frawgmanman/COSMOS23-C7-H4O/archive/2022-c7/presentations/COSMOS22-C13-1-boat.pdf

# Boat Team

Ty, Josh, Deon, Justin, Saarth, and Daisy

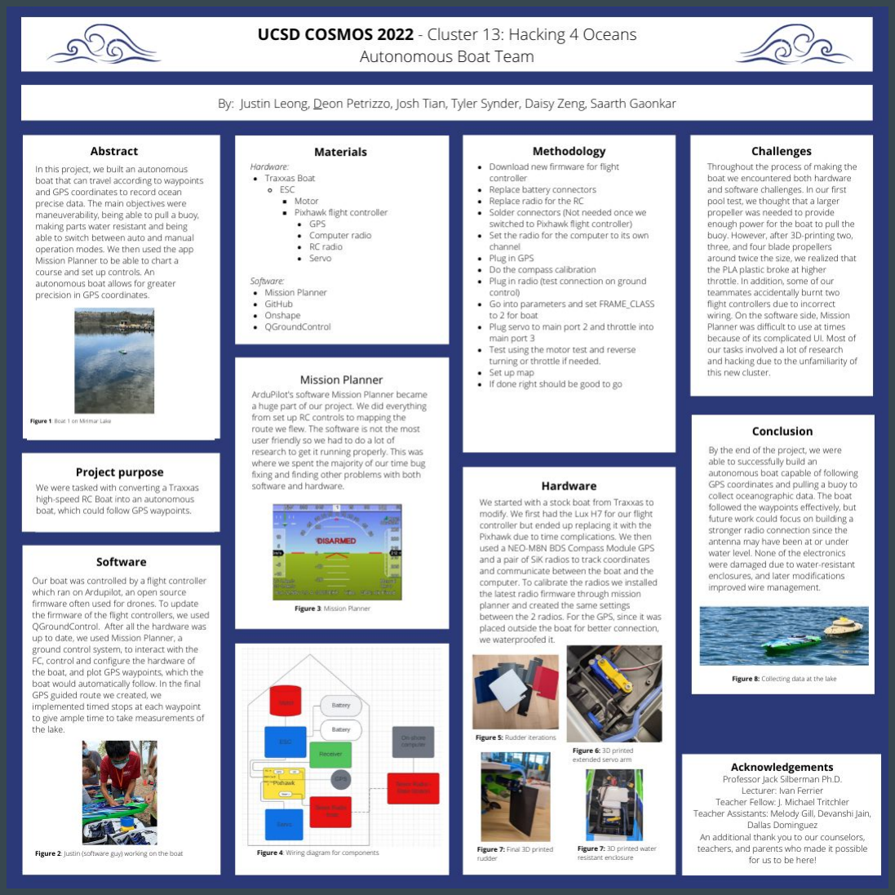
[picture p5: figure]

## Goals

- RC Boat => Autonomous Boat
- Maneuverability
- Pulling a load
- Water resistance
- Fail safe mechanism

## Software

- Ardupilot (firmware on flight controller)
- Mission Planner (ground control software)
- Configure hardware
- Plot and run GPS routes
- Add specific waypoint events

## Hardware: Electronics

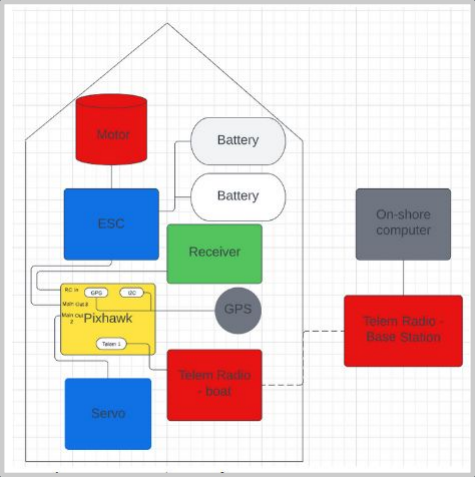
[picture p6: figure]

## Hardware: Custom 3D printed parts

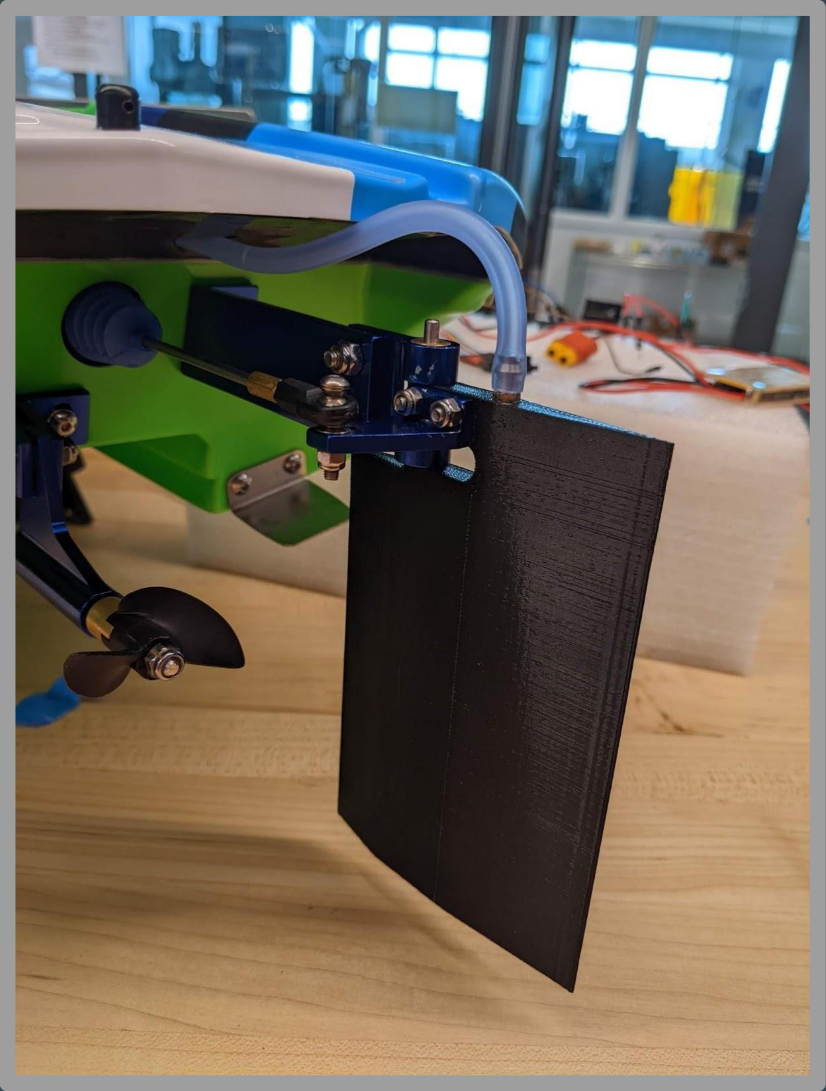
[picture p7: figure]
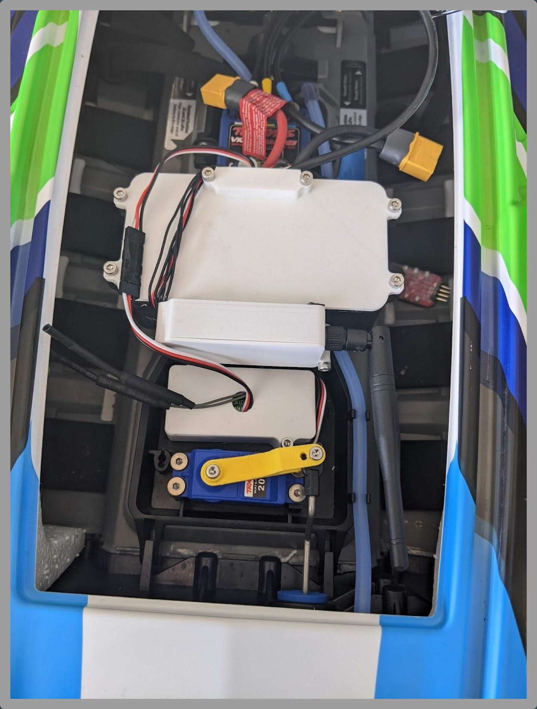
[picture p8: figure]
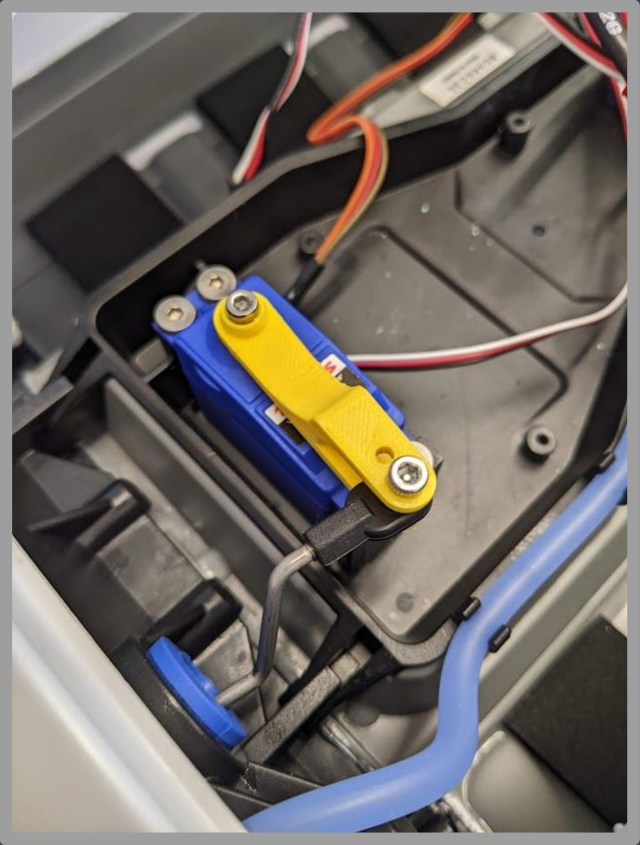
[picture p9: figure]

Improved steering system | Water resistant enclosures for the electronics

## Hardware: Iterations

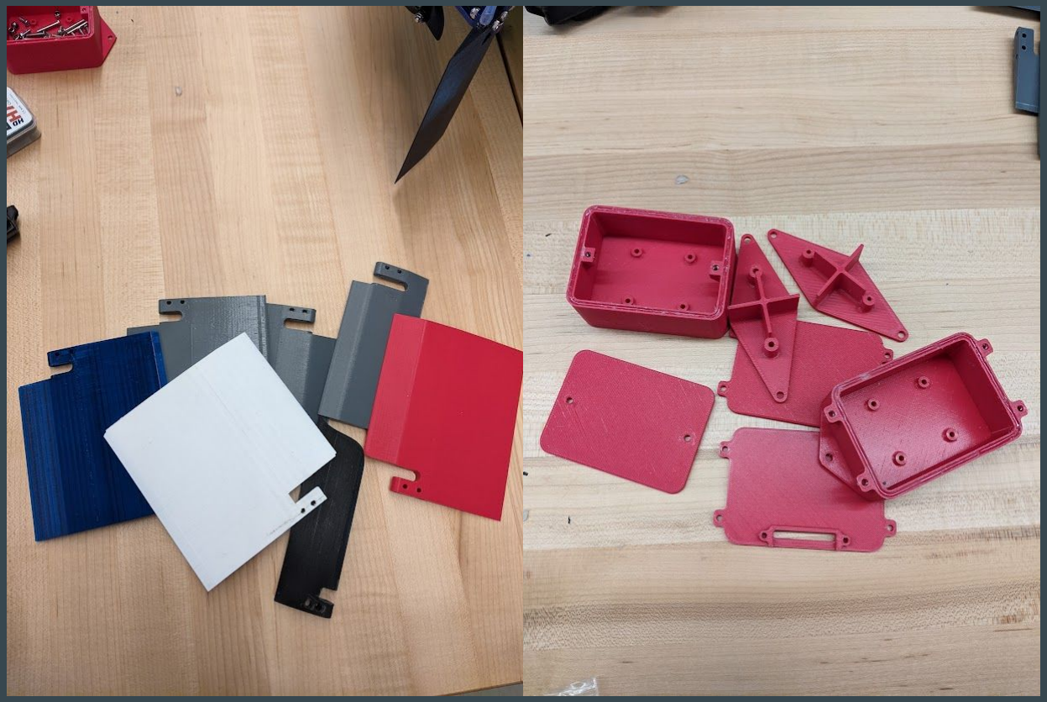
[picture p10: figure]

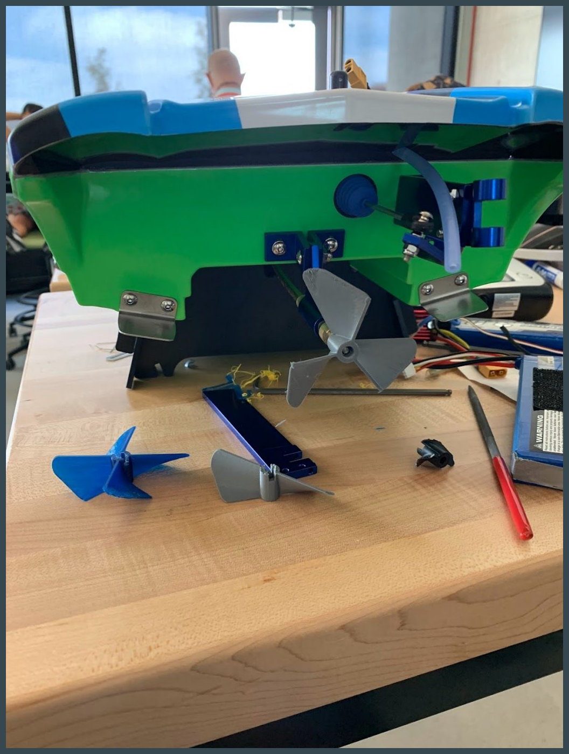
[picture p11: figure]

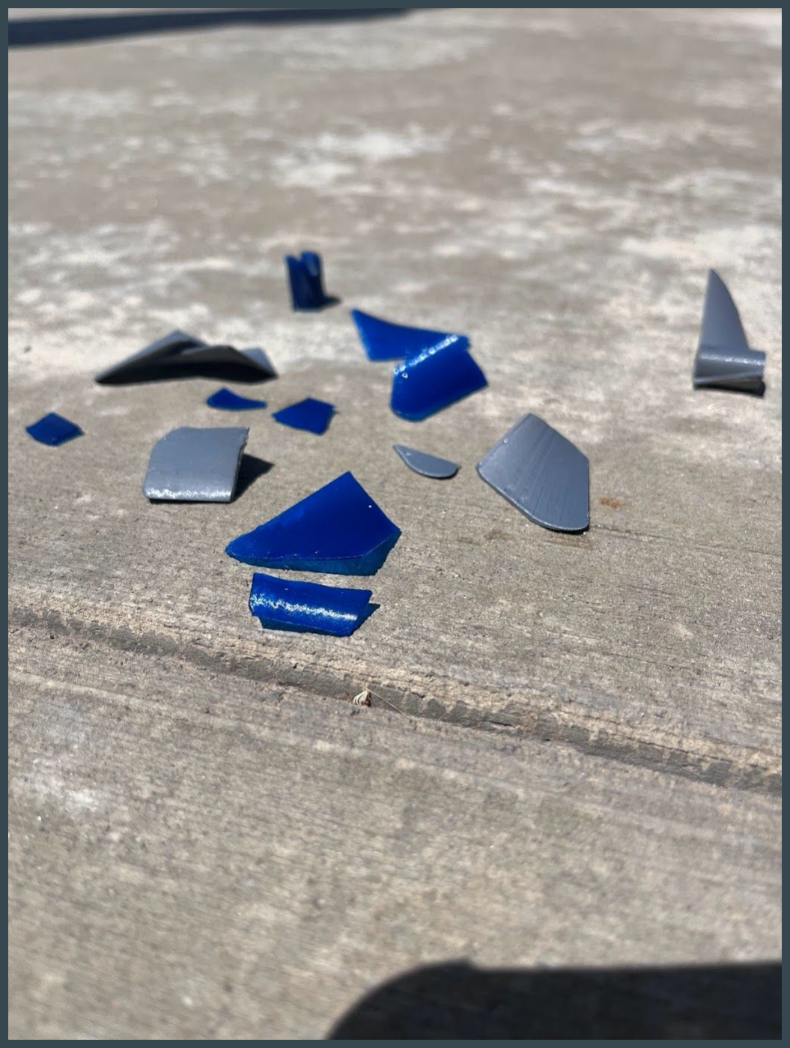
[picture p12: figure]

## Challenges

Hardware:
- Wiring GPS
- Frying boards
Software:
- Mission Planner => complicated UI
- Pairing Sik radios

## Conclusion

Success:
- Boat followed GPS waypoints
- No water damage
- Agile steering
Future Improvements:
- Stronger radio connection

## Acknowledgements

Professor: Jack Silberman Ph.D.
Lecturer: Ivan Ferrier
Teacher Fellow: J. Michael Tritchler
Teacher Assistants: Melody Gill, Devanshi Jain, Dallas Dominguez
An additional thank you to our counselors, teachers, and parents who made it possible for us to be here!
