frawgmanman/COSMOS23-C7-H4O/archive/2022-c7/presentations/COSMOS22-C13-3-data_acquisition.pdf

# UCSD COSMOS 2022

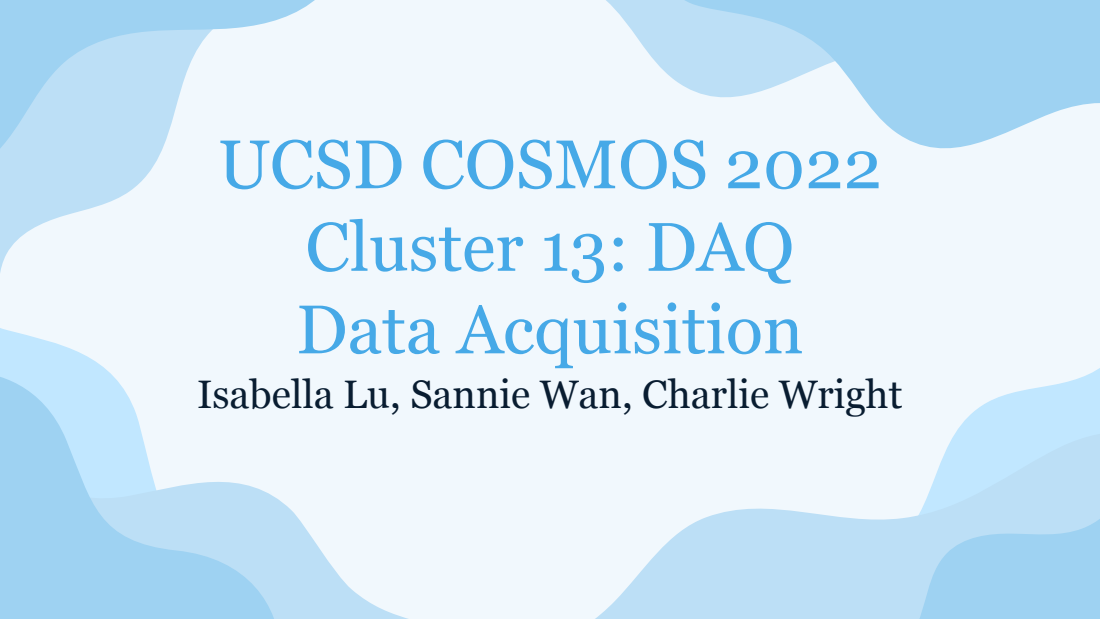
[picture p13: page 1]
Cluster 13: DAQ Data Acquisition

Isabella Lu, Sannie Wan, Charlie Wright

# Meet the Team

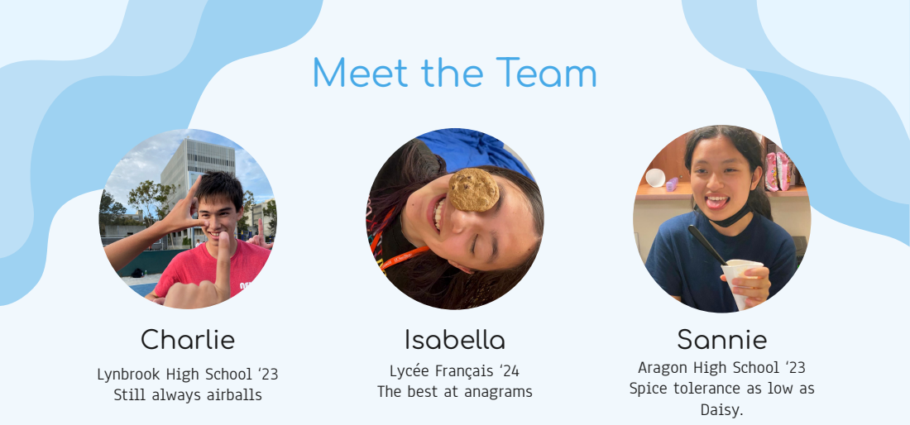
[picture p14: page 2]
Daisy.

Charlie
Lynbrook High School ‘23
Still always airballs

Isabella
Lycée Français ‘24
The best at anagrams

Sannie
Aragon High School ‘23
Spice tolerance as low as

# Background

There has recently been many contributions to big ocean data. In order to understand the environment around us through robotics, sensors were placed on a buoy, which was towed by a boat. This was driven around Miramar Reservoir.

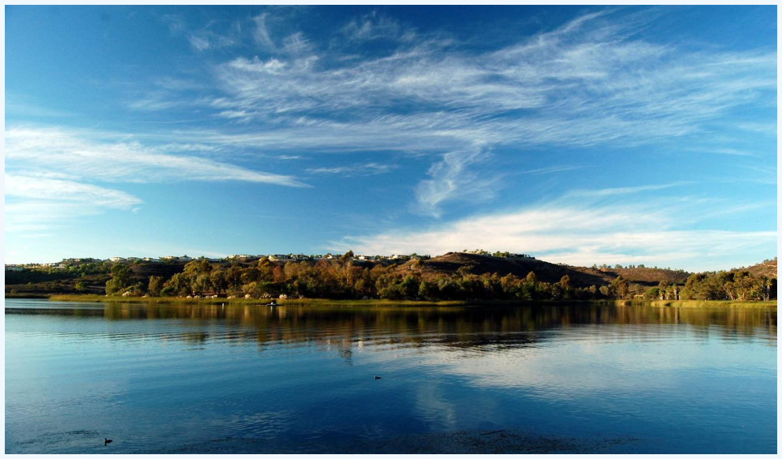
[picture p15: figure]
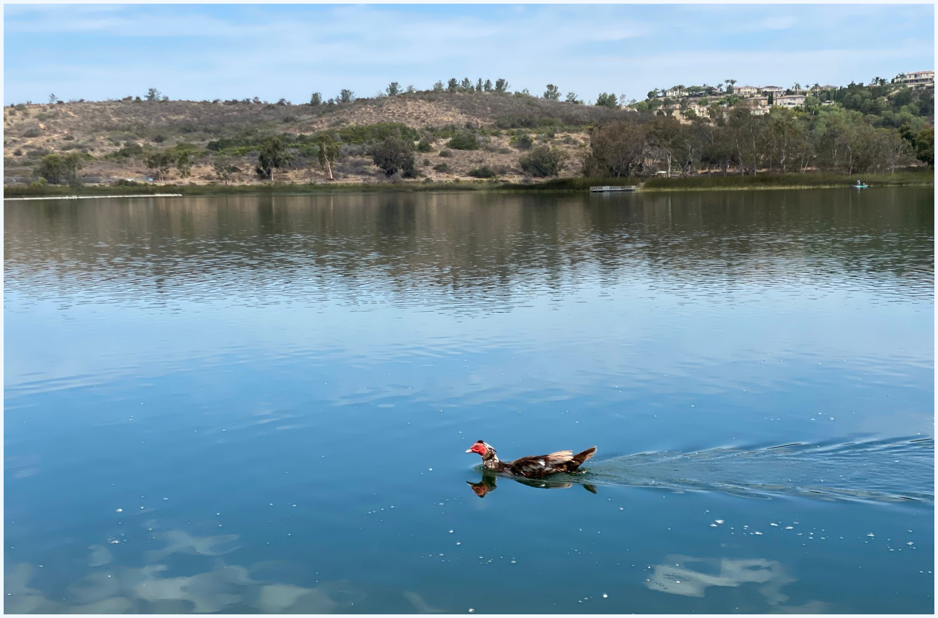
[picture p16: figure]

# Project Scope

Tasks:
- Use pH, TDS, and temperature sensors
- Collect and transmit frequent and reliable data.
- Wire up the sensors in the buoy

We communicated our data through serial communication from an arduino to ESP32.

Goal: collect pH, total dissolved solids (TDS), and temperature data from Miramar Lake, and send it back to an onshore server for further analysis.

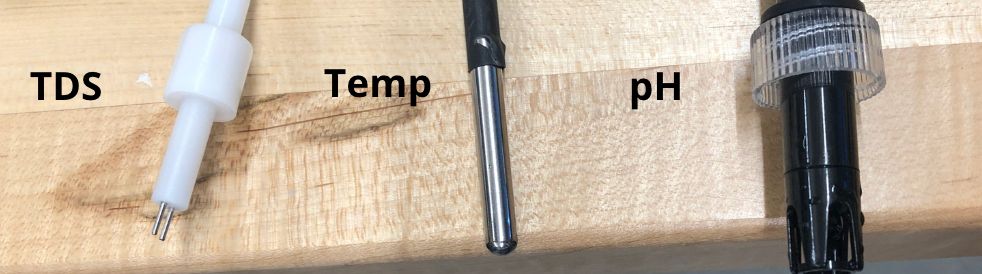
[picture p17: figure]

# Wiring diagram

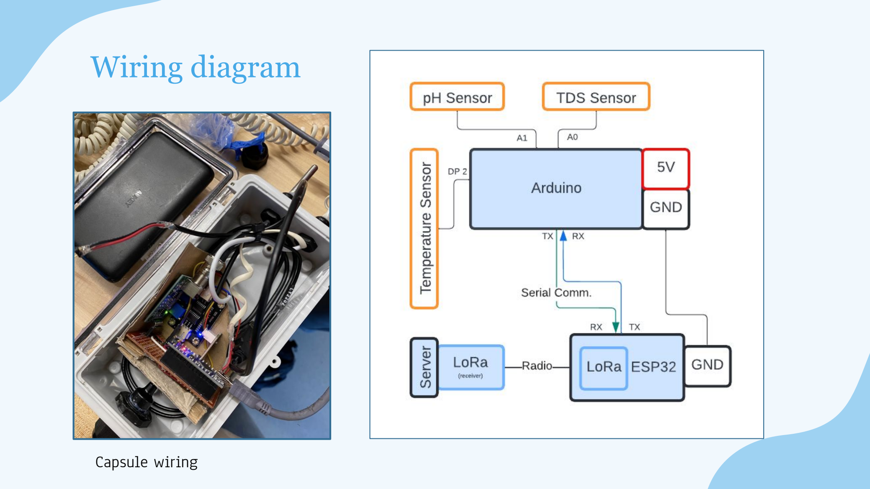
[picture p18: page 5]

## Capsule wiring

# Materials

Hardware:
- Arduino Uno and Nano
- ESP32 with LoRa
- Protoboard, breadboard
- Sensors: pH, Total
Dissolved Solids), and
temperature
- 1000 ppm TDS
calibration solution
- 4, 7, and 10 pH
calibration solution
- Thermometer
- Capsule
Hardware
- Motor
- Motor
controller

Software:
- Arduino IDE
- Github
- Onshape

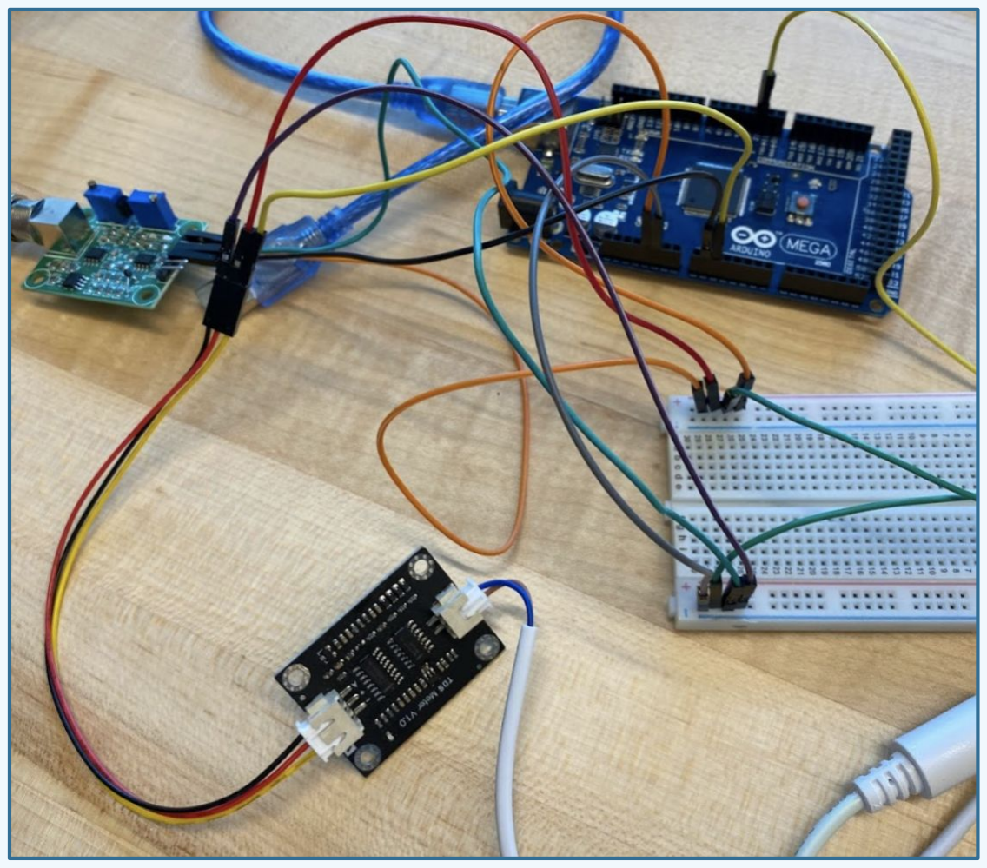
[picture p19: figure]

## Prototyping with breadboard and sensors

# Reliable Data Method

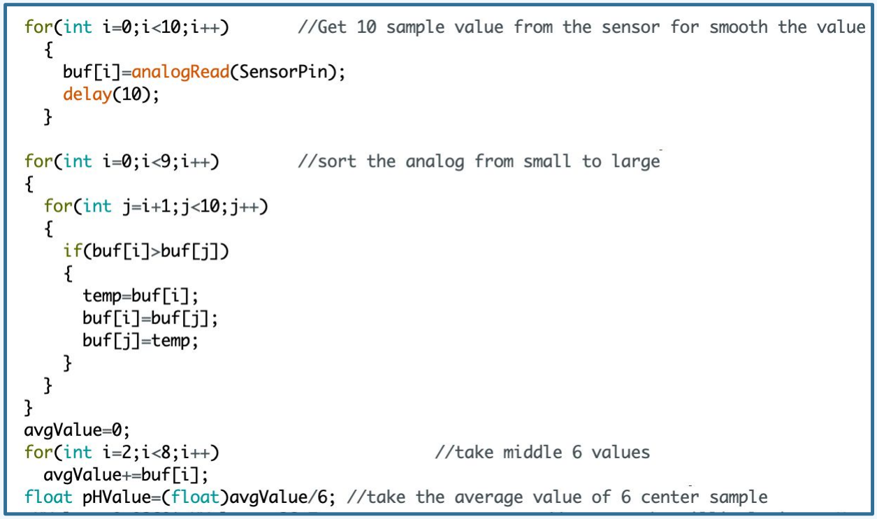
[picture p20: figure]

When taking the measurement of pH, we used:
- Oversampling (takes 10 values per function call)
- Averaging the six median values

pH oversampling →

# Sensors Calibration

We took three known data points for pH, plotted

them in a scatter chart in Google Sheets and used

the trendline tool to find the equation relating the

analog value to the actual pH value.

Then, we plugged in that equation into our

Arduino code.

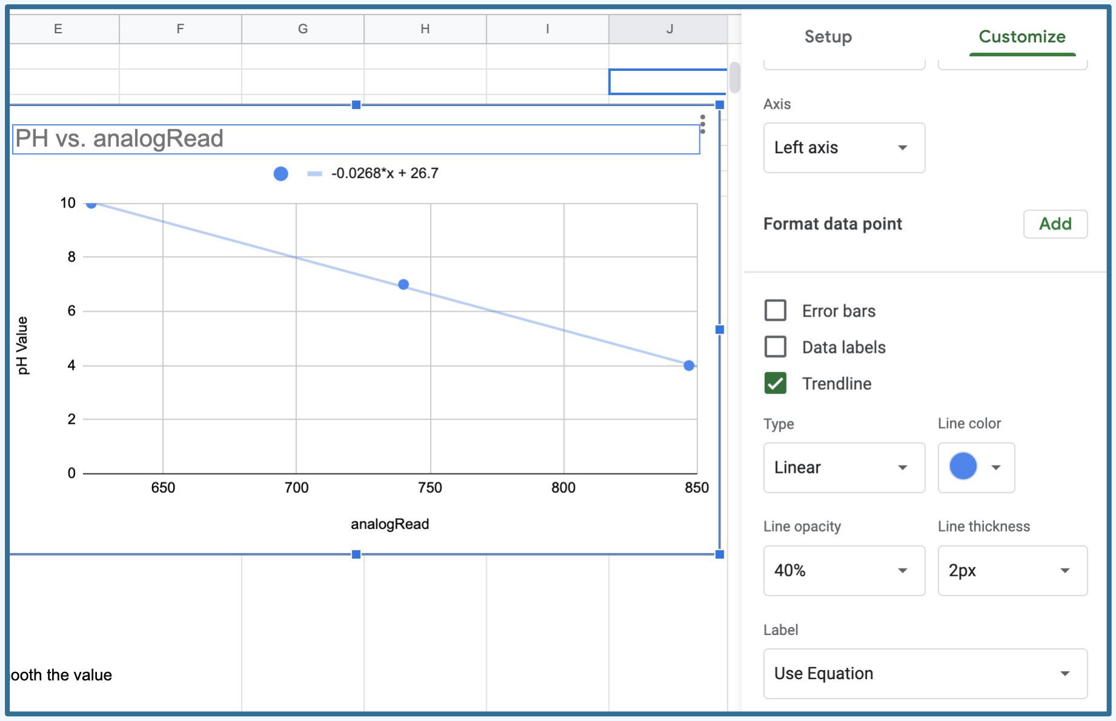
[picture p21: figure]

## Line of best fit on Google Sheets

# Challenges

- Synchronization of different electrical

components–communication with other teams to

coordinate "who sends what and when"

- Uploading code to the ESP32
- Flooding in the buoy
- Had to re-calibrate and test all sensors as

well as replace some

- Sensor inconsistency, especially with the pH and

TDS sensor

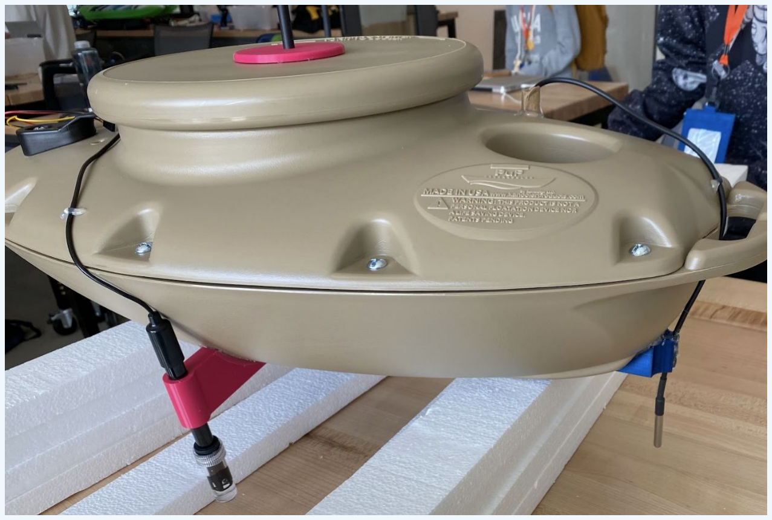
[picture p22: figure]

Buoy 1 with pH sensor (left) and temperature sensor (right). TDS sensor not shown.

# Field testing Results

- In a controlled environment, the sensor readings had very high accuracy
- Immediately after dropping in the lake, pH was inaccurate: 15-18
- Realistic pH: 7-8
- TDS might be too high: ~1000 ppm
- Realistic TDS: 50-300
- 2136 data points around the lake were collected
- Data was gibberish initially during testing due to a wiring malfunction, troubleshooted at the lake

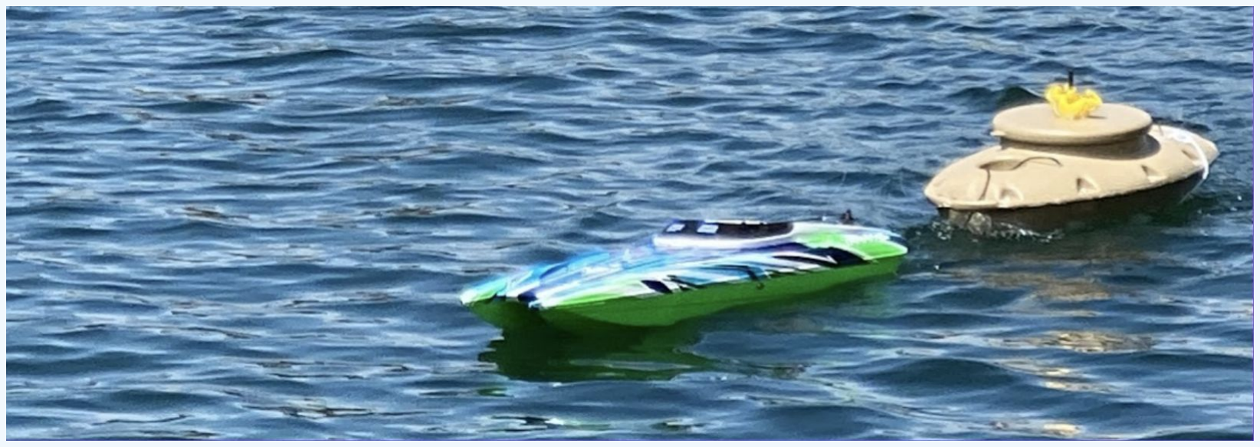
[picture p23: figure]

# Opportunities for further research

- Understand the root causes of wrong data values
- Possible reasons: wind, not fully submerged, current, temperature
- We tested fast-flowing sample lake water with pH sensor. The pH didn’t change significantly. According to our observations, current did not affect pH.
- Temperature of the lake was not in the extremes
- More verification such as pH test strips
- More time for field testing
- Testing sensors deeper in the lake

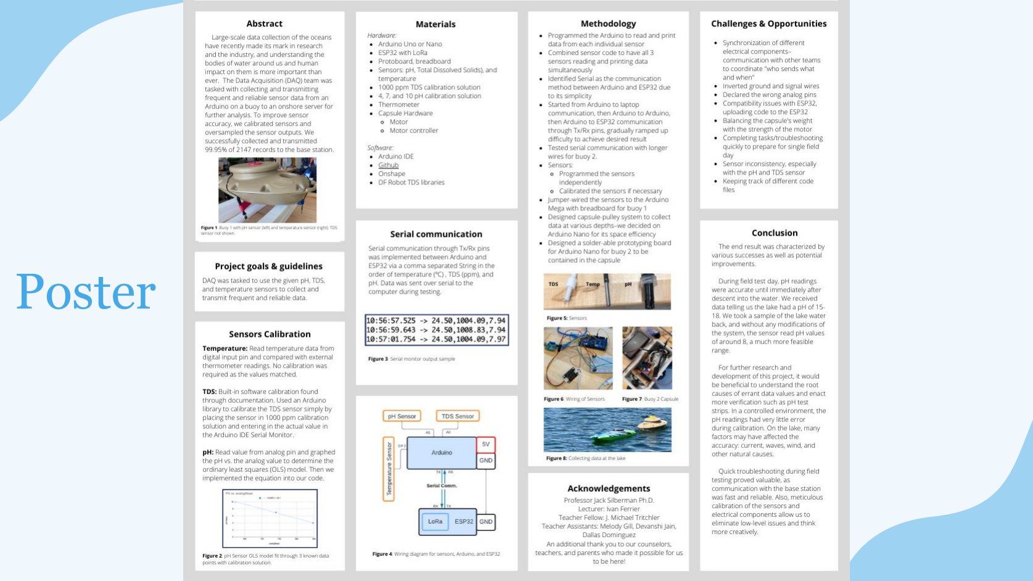
[picture p24: page 12]

# Poster

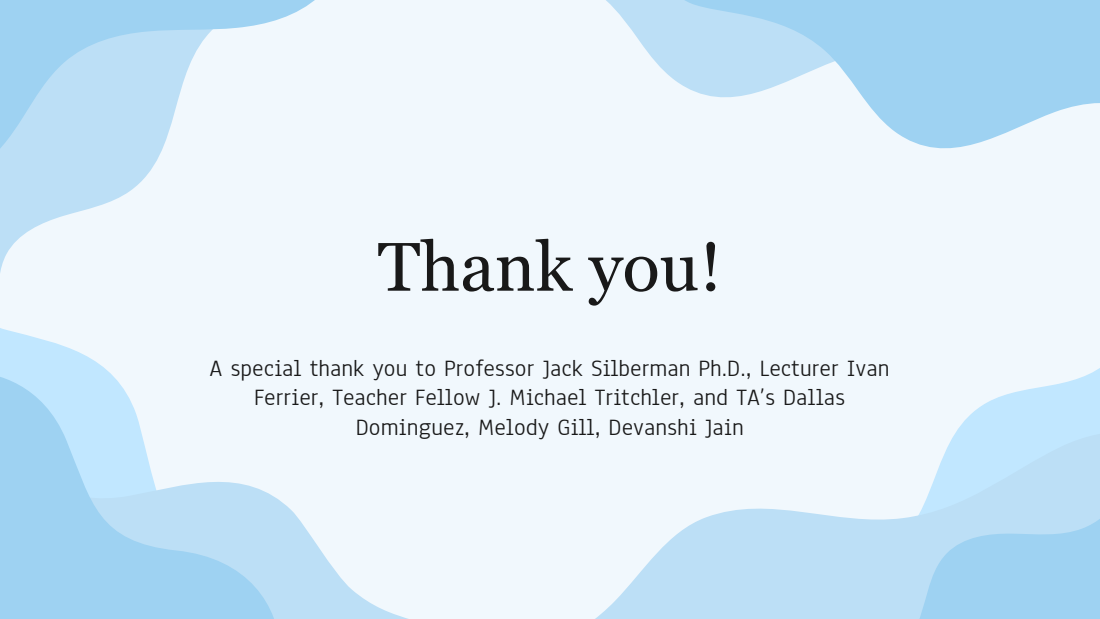
[picture p25: page 13]
Thank you!

A special thank you to Professor Jack Silberman Ph.D., Lecturer Ivan
Ferrier, Teacher Fellow J. Michael Tritchler, and TA’s Dallas

Dominguez, Melody Gill, Devanshi Jain
