frawgmanman/COSMOS23-C7-H4O/archive/2022-c7/2-buoy/Buoy2/PostTestDay/General_Assembly.step

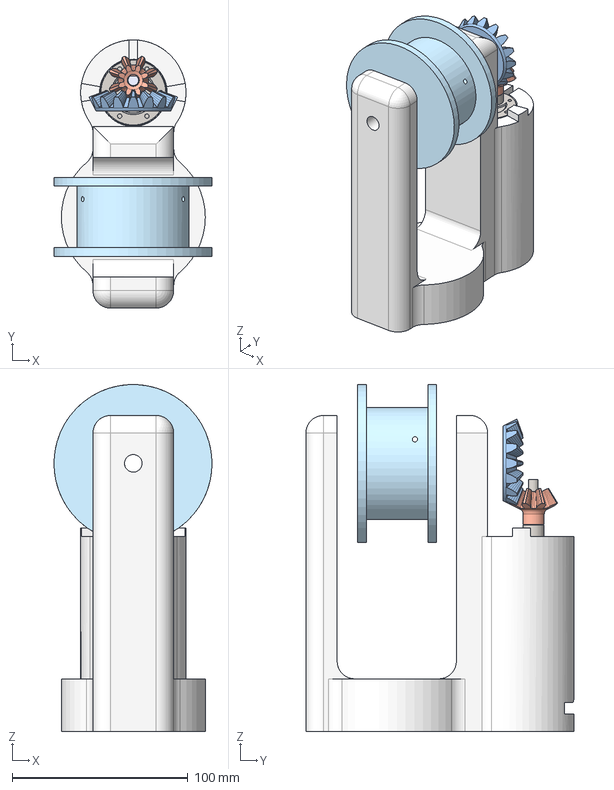
[picture p26: CAD file, 2023-07-07, an earlier design]
archive/2022-c7/2-buoy/Buoy2/PostTestDay/General_Assembly.step
90.0 x 152.7 x 197.6 mm
Gear 1
Gear 2
am-2964a Neverest Classic 40
