frawgmanman/COSMOS23-C7-H4O/archive/2022-c7/2-buoy/Buoy2/(Final) Cup Holder Piece (2).stl

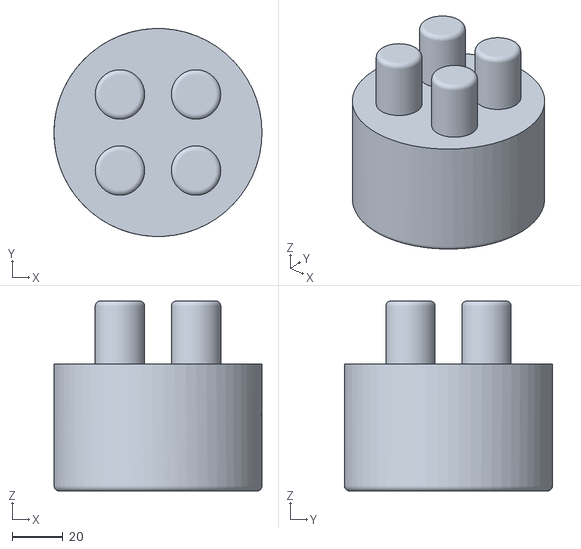
[picture p28: CAD file, 2023-07-07, an earlier design]
archive/2022-c7/2-buoy/Buoy2/(Final) Cup Holder Piece (2).stl
82.0 x 82.0 x 74.9
