frawgmanman/COSMOS23-C7-H4O/archive/2022-c7/2-buoy/Capsule/Arduino Uno Case - Top.step

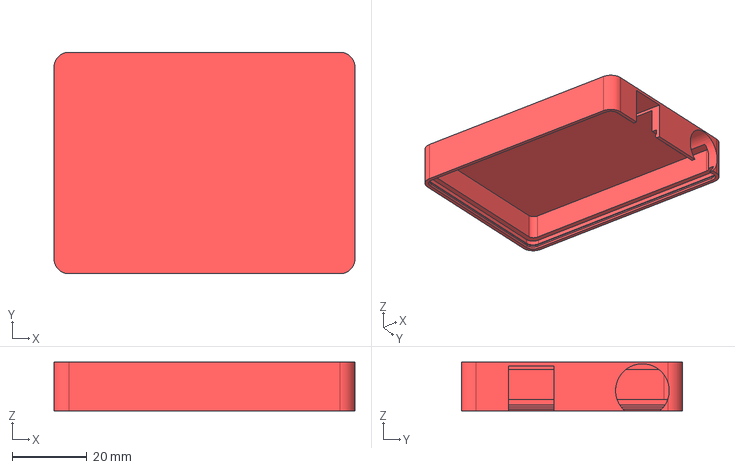
[picture p29: CAD file, 2023-07-07, an earlier design]
archive/2022-c7/2-buoy/Capsule/Arduino Uno Case - Top.step
80.6 x 59.3 x 13.0 mm
