frawgmanman/COSMOS23-C7-H4O/archive/2022-c7/2-buoy/Buoy1/Spool wheel first iteration.step

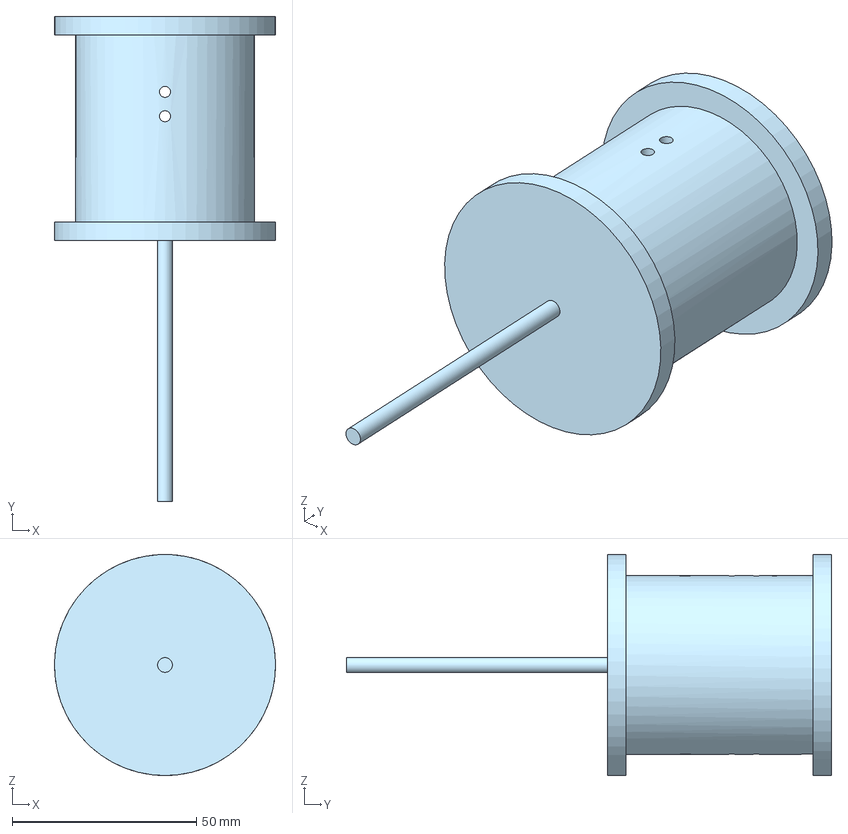
[picture p30: CAD file, 2023-07-07, an earlier design]
archive/2022-c7/2-buoy/Buoy1/Spool wheel first iteration.step
60.0 x 131.7 x 60.0 mm
