frawgmanman/COSMOS23-C7-H4O/archive/2022-c7/2-buoy/Buoy2/PostTestDay/Motor_Casing_Structure (1).step

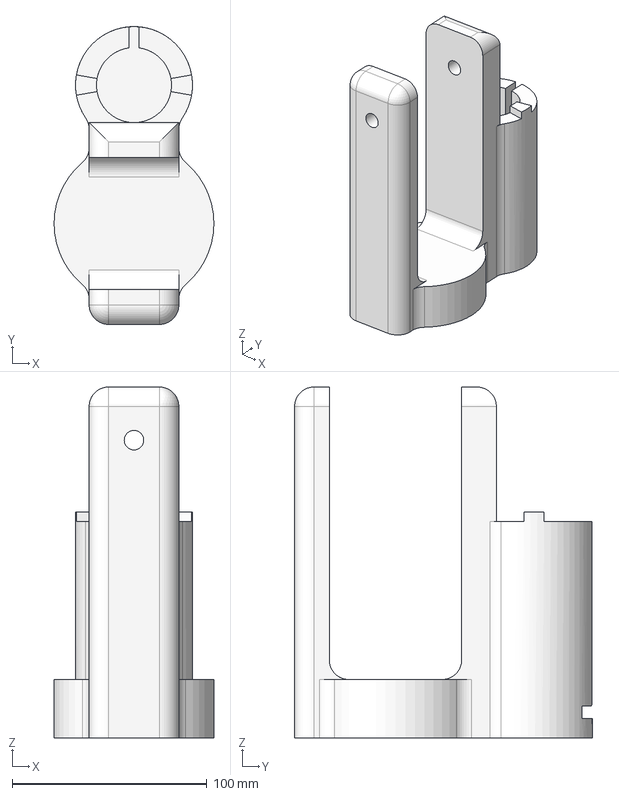
[picture p31: CAD file, 2023-07-07, an earlier design]
archive/2022-c7/2-buoy/Buoy2/PostTestDay/Motor_Casing_Structure (1).step
82.0 x 152.7 x 180.0 mm
