frawgmanman/COSMOS23-C7-H4O/archive/2022-c7/2-buoy/Capsule/Arduino Uno Case - Bottom.step

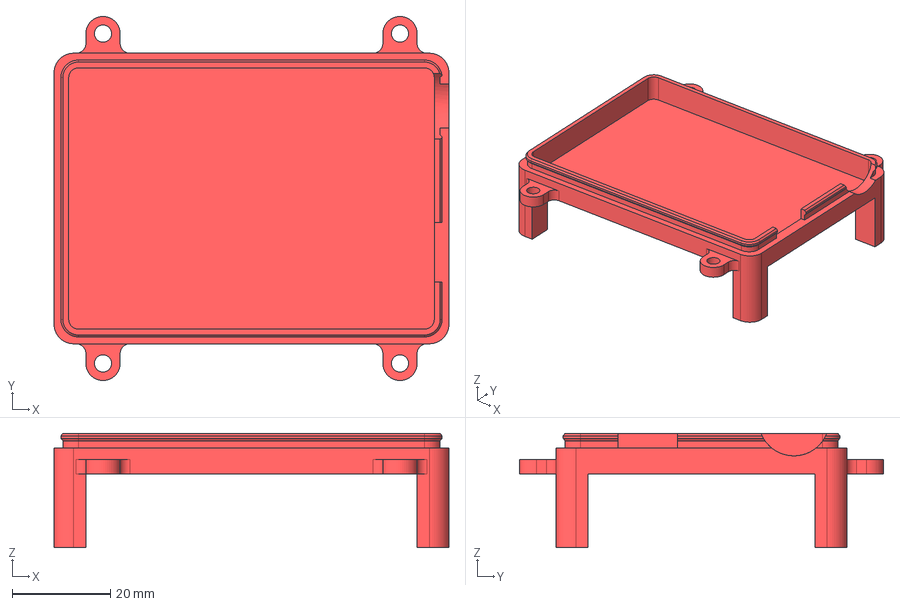
[picture p32: CAD file, 2023-07-07, an earlier design]
archive/2022-c7/2-buoy/Capsule/Arduino Uno Case - Bottom.step
80.6 x 74.3 x 23.3 mm
