frawgmanman/COSMOS23-C7-H4O/archive/2022-c7/2-buoy/Buoy1/Ph sensor.step

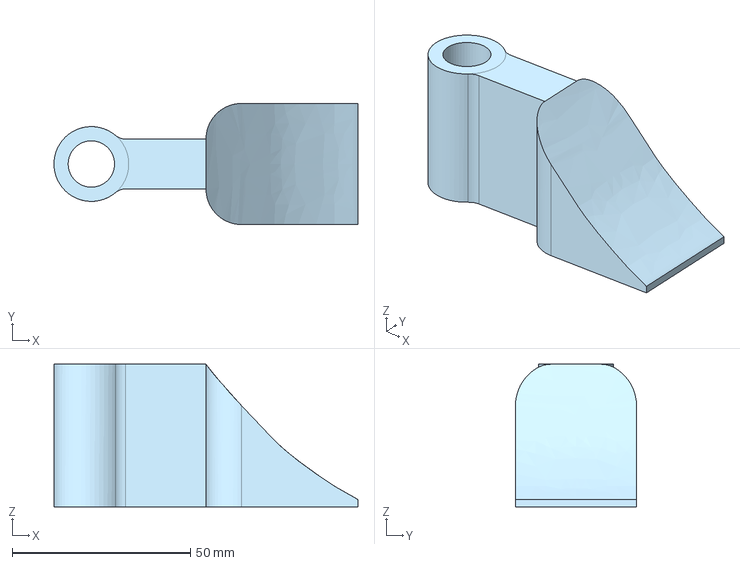
[picture p33: CAD file, 2023-07-07, an earlier design]
archive/2022-c7/2-buoy/Buoy1/Ph sensor.step
85.3 x 34.0 x 40.0 mm
