frawgmanman/COSMOS23-C7-H4O/archive/2022-c7/2-buoy/Buoy2/Final Spool Wheel (1).stl

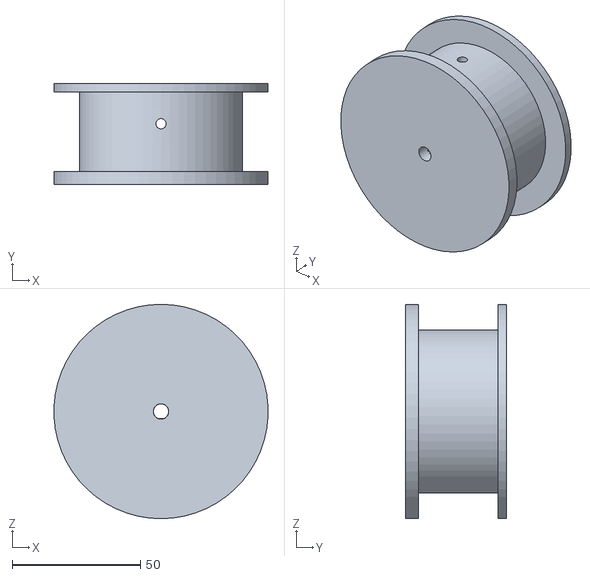
[picture p34: CAD file, 2023-07-07, an earlier design]
archive/2022-c7/2-buoy/Buoy2/Final Spool Wheel (1).stl
83.5 x 39.6 x 83.7
