frawgmanman/COSMOS23-C7-H4O/archive/2022-c7/2-buoy/Buoy2/PostTestDay/Gear_1_1.step

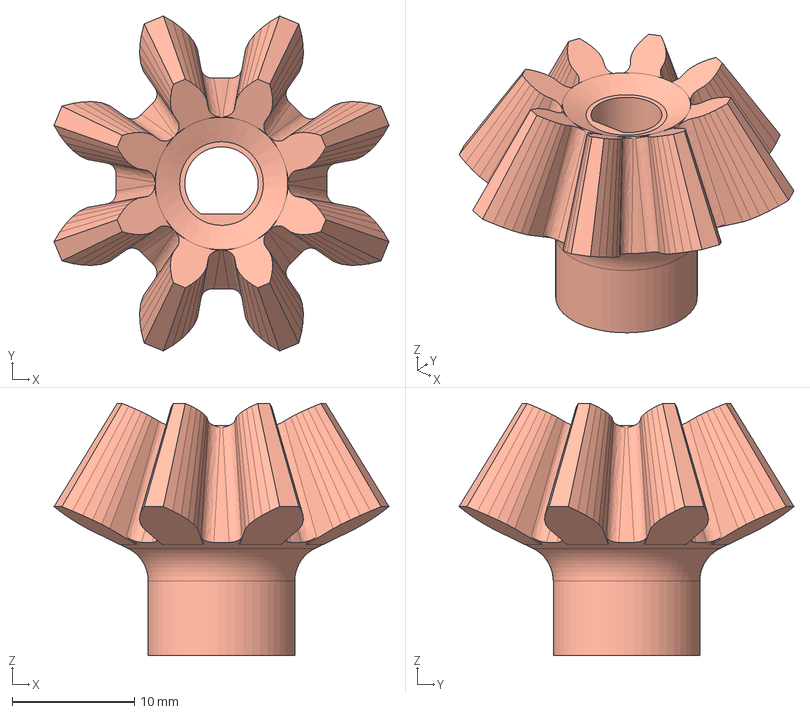
[picture p35: CAD file, 2023-07-07, an earlier design]
archive/2022-c7/2-buoy/Buoy2/PostTestDay/Gear_1_1.step
27.4 x 27.4 x 20.6 mm
