frawgmanman/COSMOS23-C7-H4O/archive/2022-c7/2-buoy/Buoy2/PostTestDay/Spool.step

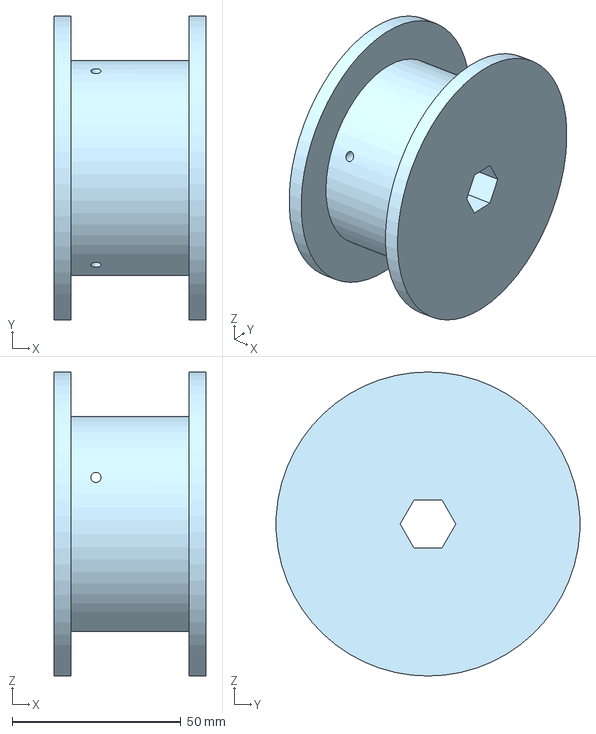
[picture p36: CAD file, 2023-07-07, an earlier design]
archive/2022-c7/2-buoy/Buoy2/PostTestDay/Spool.step
45.0 x 89.9 x 90.0 mm
