frawgmanman/COSMOS23-C7-H4O/archive/2022-c7/2-buoy/Buoy2/Spool Holder v1 (1).stl

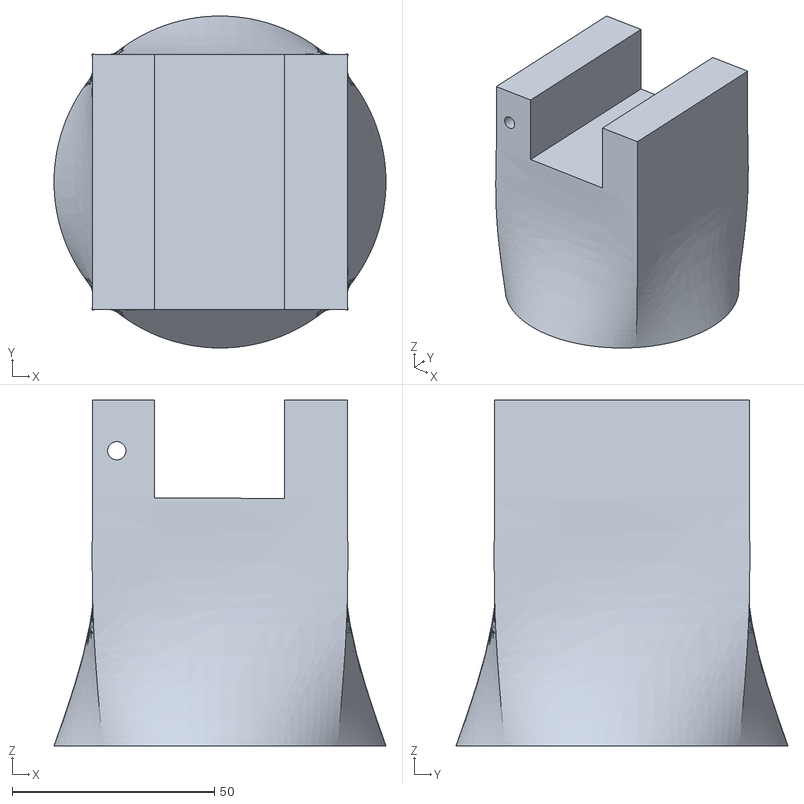
[picture p37: CAD file, 2023-07-07, an earlier design]
archive/2022-c7/2-buoy/Buoy2/Spool Holder v1 (1).stl
82.0 x 82.0 x 85.4
