frawgmanman/COSMOS23-C7-H4O/archive/2022-c7/2-buoy/Buoy1/TDS and PH wire holder - bottom.step

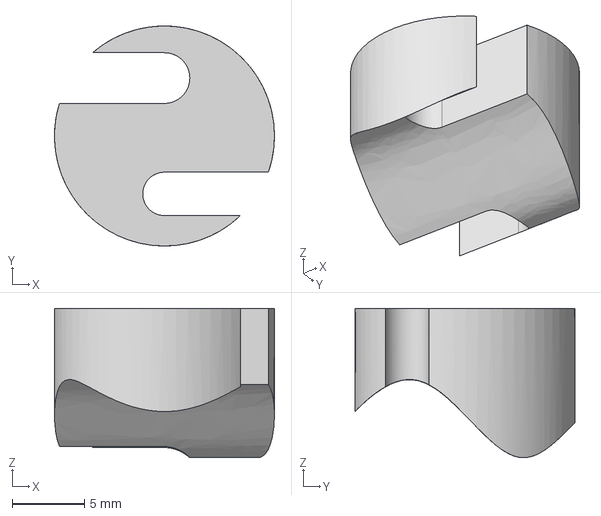
[picture p38: CAD file, 2023-07-07, an earlier design]
archive/2022-c7/2-buoy/Buoy1/TDS and PH wire holder - bottom.step
15.2 x 15.2 x 10.3 mm
