frawgmanman/COSMOS23-C7-H4O/archive/2022-c7/2-buoy/Buoy1/TDS sensor enclosure.step

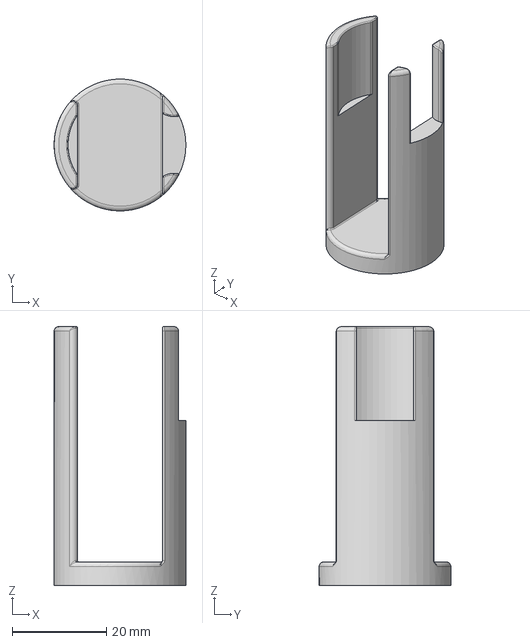
[picture p39: CAD file, 2023-07-07, an earlier design]
archive/2022-c7/2-buoy/Buoy1/TDS sensor enclosure.step
28.0 x 28.0 x 55.0 mm
