frawgmanman/COSMOS23-C7-H4O/archive/2022-c7/2-buoy/Buoy1/Temp holder - bottom.step

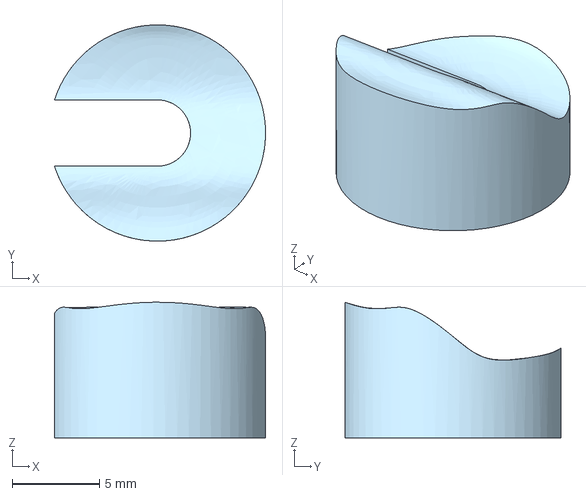
[picture p40: CAD file, 2023-07-07, an earlier design]
archive/2022-c7/2-buoy/Buoy1/Temp holder - bottom.step
12.1 x 12.4 x 7.77 mm
