frawgmanman/COSMOS23-C7-H4O/(list of files, cad)

Other CAD files:
archive/2022-c7/2-buoy/Buoy1/Motor_Casing_Attachment_Lego_Adapter.step
archive/2022-c7/2-buoy/Buoy2/Spool Wheel (1).stl
archive/2022-c7/2-buoy/Buoy1/Spool holder first iteration.step
archive/2022-c7/2-buoy/Buoy1/TDS Sensor base.step
archive/2022-c7/2-buoy/Buoy1/TDS and PH wire holder - top.step
archive/2022-c7/2-buoy/Buoy1/Temperature holder.step
