frawgmanman/COSMOS23-C7-H4O/Sensors/temperature.ino

#include <OneWire.h>
#include <DallasTemperature.h>

// GPIO where the DS18B20 is connected to
const int oneWireBus = 4;     

// Setup a oneWire instance to communicate with any OneWire devices
OneWire oneWire(oneWireBus);

// Pass our oneWire reference to Dallas Temperature sensor 
DallasTemperature sensors(&oneWire);

void setup() {
  // Start the Serial Monitor
  Serial.begin(115200);
  // Start the DS18B20 sensor
  sensors.begin();
}

void loop() {
  sensors.requestTemperatures(); 
  float temperatureK = sensors.getTempCByIndex(0) + 273.15;
// float temperatureF = sensors.getTempFByIndex(0);
//   Serial.print(temperatureK);
//   Serial.println("ºC");
//   Serial.print(temperatureF);
//   Serial.println("ºF");
  //Serial.println(count);
  delay(5000);
}
