frawgmanman/COSMOS23-C7-H4O/Sensors/pH.ino

const int SensorPin = 0;
int buf[10];
int temp;
int avgValue;


void setup() {
// put your setup code here, to run once:
Serial.begin(9600); // Initialize the serial communication for debugging (optional)
}


void loop() {
// put your main code here, to run repeatedly:
// Read the pH value and perform any desired actions
float phValue = getPh();
// Do something with the pH value
Serial.print("pH value: ");
Serial.println(phValue); // Print the pH value to the serial monitor (optional)
delay(1000); // Delay for 1 second before taking another reading
}


float getPh() {
for (int i = 0; i < 10; i++) { // Get 10 sample values from the sensor to smooth the value
buf[i] = analogRead(SensorPin);
delay(10);
}
for (int i = 0; i < 9; i++) { // Sort the analog values from small to large
for (int j = i + 1; j < 10; j++) {
if (buf[i] > buf[j]) {
temp = buf[i];
buf[i] = buf[j];
buf[j] = temp;
}
}
}
avgValue = 0;
for (int i = 2; i < 8; i++) { // Take the average value of the 6 center samples
avgValue += buf[i];
Serial.print("Value");
Serial.println(buf[i]);
}
float voltage = avgValue * (5.0 / 1023.0); // Convert the analog value to voltage
float phValue = voltage + 1.5; // Convert the voltage to pH value using a linear equation
return phValue;
}
