frawgmanman/COSMOS23-C7-H4O/testing/ethernetReciever.ino

#include <SoftwareSerial.h>

const static byte eRx = 4;
const static byte eTx = 5;
SoftwareSerial eCom(eRx, eTx);



void setup(){
    Serial.begin(57600);
    eCom.begin(57600);
}

void loop(){
    if(eCom.available()){
        char data = (char)eCom.read();
        Serial.println(data);
    }
    else{
        Serial.println("sob");
    }
}
