frawgmanman/COSMOS23-C7-H4O/(commit log)

2023-07-07 Create 2023 Cluster 7
    Create the repository for COSMOS 2023 Cluster 7.
    [(Final) Cup Holder Piece (2).stl, (Final) Cup Holder Piece (3).stl, Arduino Uno Case - Bottom.step, Arduino Uno Case - Top.step, Final Spool Wheel (1).stl, Gear_1_1.step, General_Assembly.step, Motor_Casing_Attachment_Lego_Adapter.step]
2023-07-07 Update archive 2022 directory
    [(Final) Cup Holder Piece (2).stl, (Final) Cup Holder Piece (3).stl, Arduino Uno Case - Bottom.step, Arduino Uno Case - Top.step, Final Spool Wheel (1).stl, Gear_1_1.step, General_Assembly.step, Motor_Casing_Attachment_Lego_Adapter.step]
2023-07-12 rudimentary sensor code
    will standardize data formatting later; this is just code that works
2023-07-18 added temperature code
2023-07-18 added temperature codee
2023-07-19 Create gyroscope (arduino).ino
2023-07-19 solved utf8 data conversion issue
    [big-code-thing.ino]
2023-07-20 bug fixes and refactoring
    [big-code-thing.ino]
2023-07-25 add sensors to winch and edit formatting
2023-07-31 add sensors
